CREPP-PLOEMEUR/SimpleCDBot/README.md

<!--# SimpleCDBot -->
<!--+ 2012 -->
<!--$ Arduino-->
<!--$ Electronique -->
<!--% Un robot pédagogique pour apprendre les bases de l'électronique. Il s'agit du premier robot réalisé au sein de l'association. -->

### SimpleCDBot

Un robot pédagogique pour apprendre les bases de l'électronique. Il s'agit du premier robot réalisé au sein de l'association.

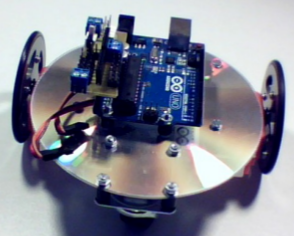
[picture p1: .img/simpleCDbot.png]
SimpleCDBot


- Librairie contenant les fonctions utiles pour le simpleCDBot, robot d'initiation à 2 servomoteurs à rotation continue. 
Nécessite l'utilisation de la librairie Utils pour permettre le contrôle du robot directement depuis le port série.
